psamtam/DIYAirPurifier_Code/doc/AirPurifierSchematic_BluePill.png

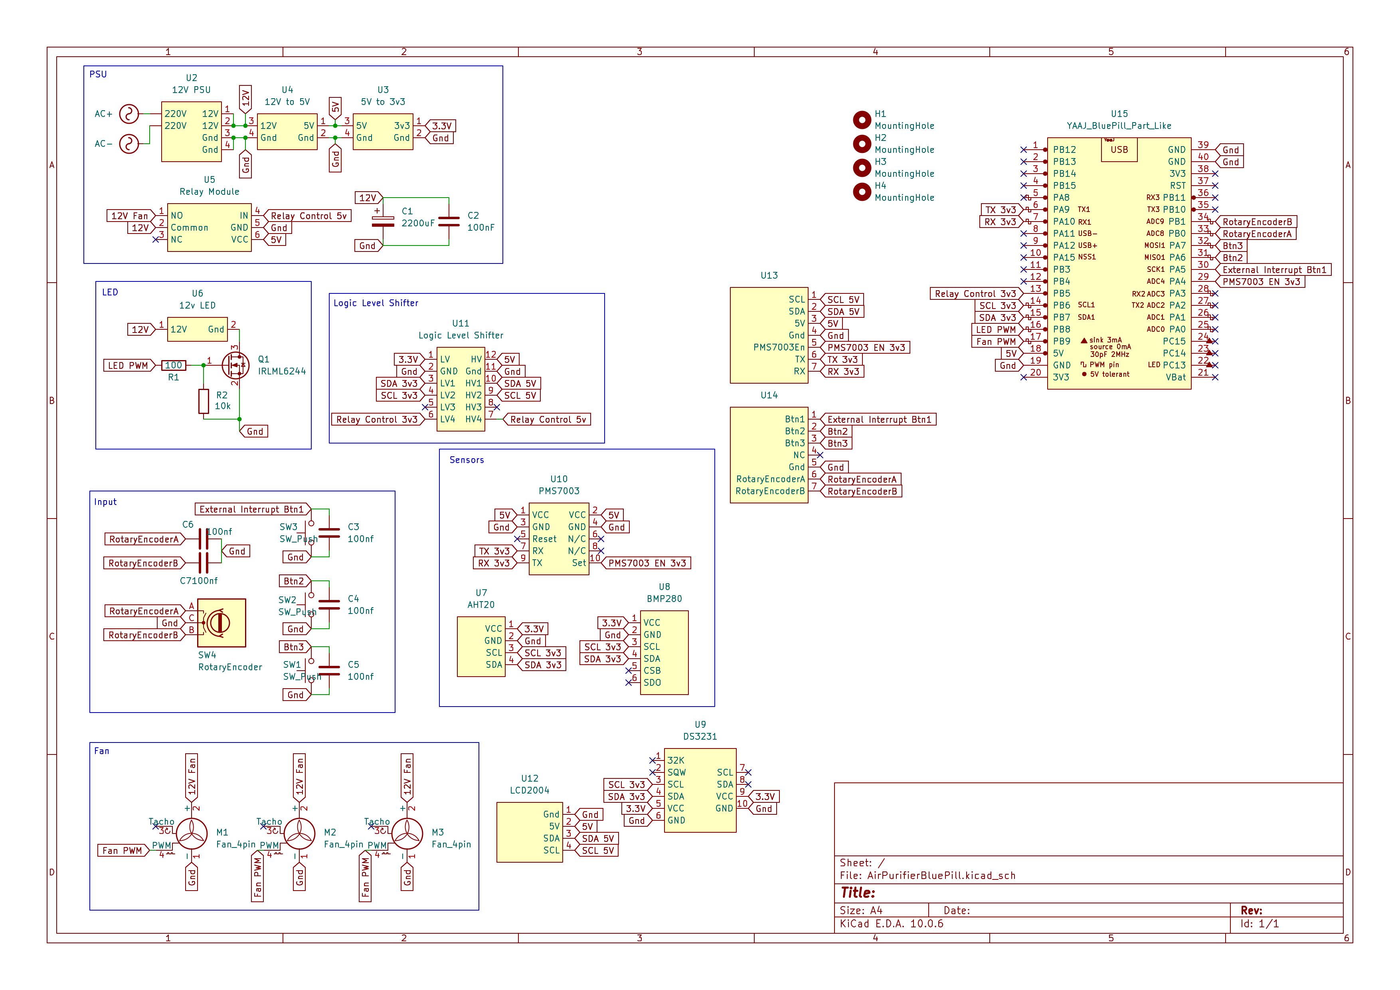
doc/AirPurifierSchematic_BluePill.png
