psamtam/DIYAirPurifier_Code/src/AirPurifier/SettingId.h

#ifndef SETTINGID_H
#define SETTINGID_H

#include <Arduino.h>

enum SettingId : uint8_t {
  SET_BACKLIGHT, SET_ROTATION, SET_STANDBY_LCD_N, SET_PMS_ENABLE,
  SET_PM_WINDOW, SET_OPERATING_SENSOR, SET_STANDBY_SENSOR, SET_AUTO_STANDBY
};

#endif
