psamtam/DIYAirPurifier_Code/(commit log)

2026-10-30 Programme code fits into Arduino, but runs with bugs
    [AirPurifier.ino, ButtonState.h, Config.h, SettingId.h]
2026-10-30 Still with bug, but kind of use-able
    [AirPurifier.ino]
2026-10-30 Date time can be set, standby mode fixed, but can't navigate through menu
    [AirPurifier.ino]
2026-10-31 Add factory reset feature, and updated UI
    [AirPurifier.ino]
2026-10-31 Just need the stand by screen fixed
    [AirPurifier.ino]
2026-10-31 Low Power standby works, but no temp / humidity
2026-10-31 Finally everything works. No bugs found yet
    [AirPurifier.ino]
2026-11-05 Upload schematic for blue pill version
